MagerValp/fifogfx/schematics/Rev1/FIFO Board Rev1.pdf

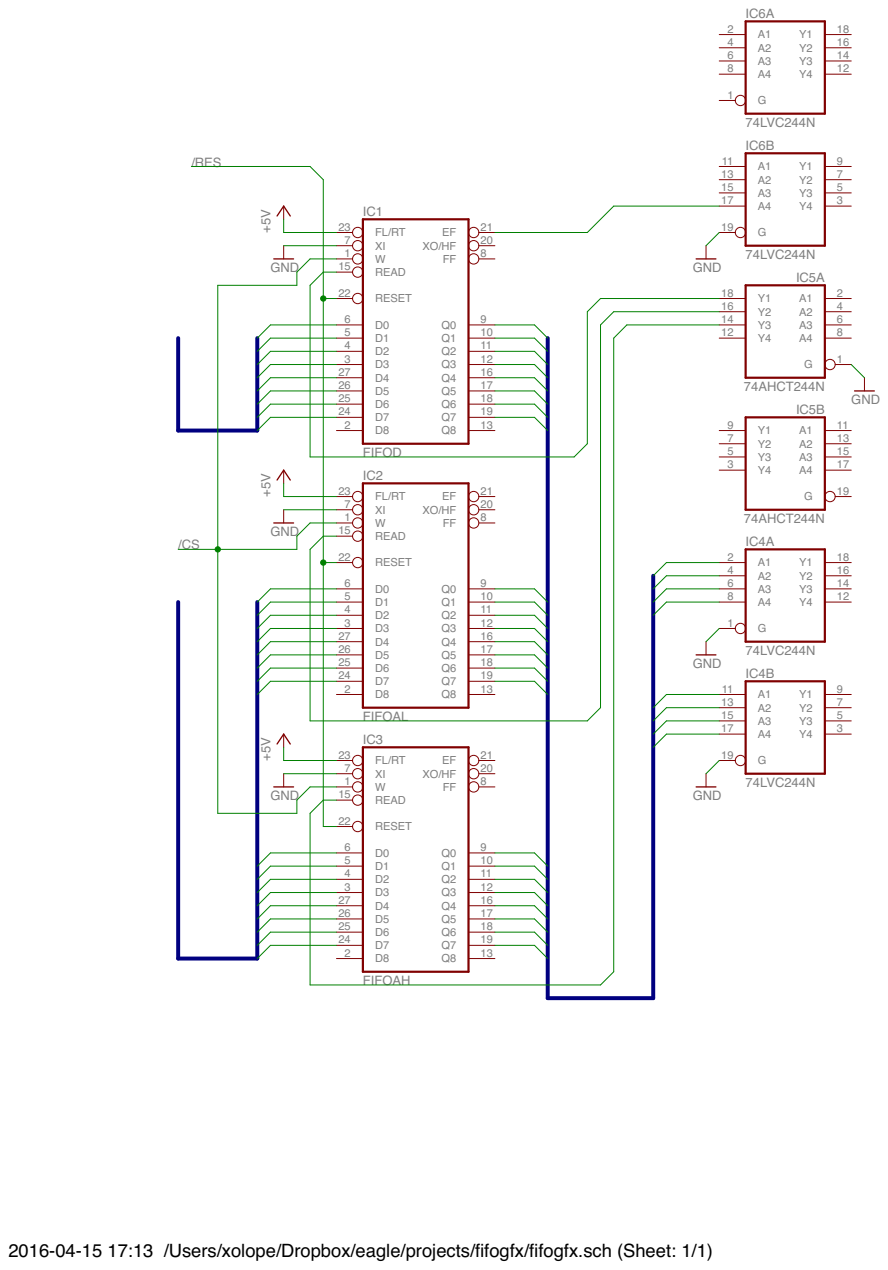
[picture p5: page 1]

2016-04-15 17:13 /Users/xolope/Dropbox/eagle/projects/fifogfx/fifogfx.sch (Sheet: 1/1)
