MagerValp/fifogfx/schematics/Rev2/FIFO Board Rev2.pdf

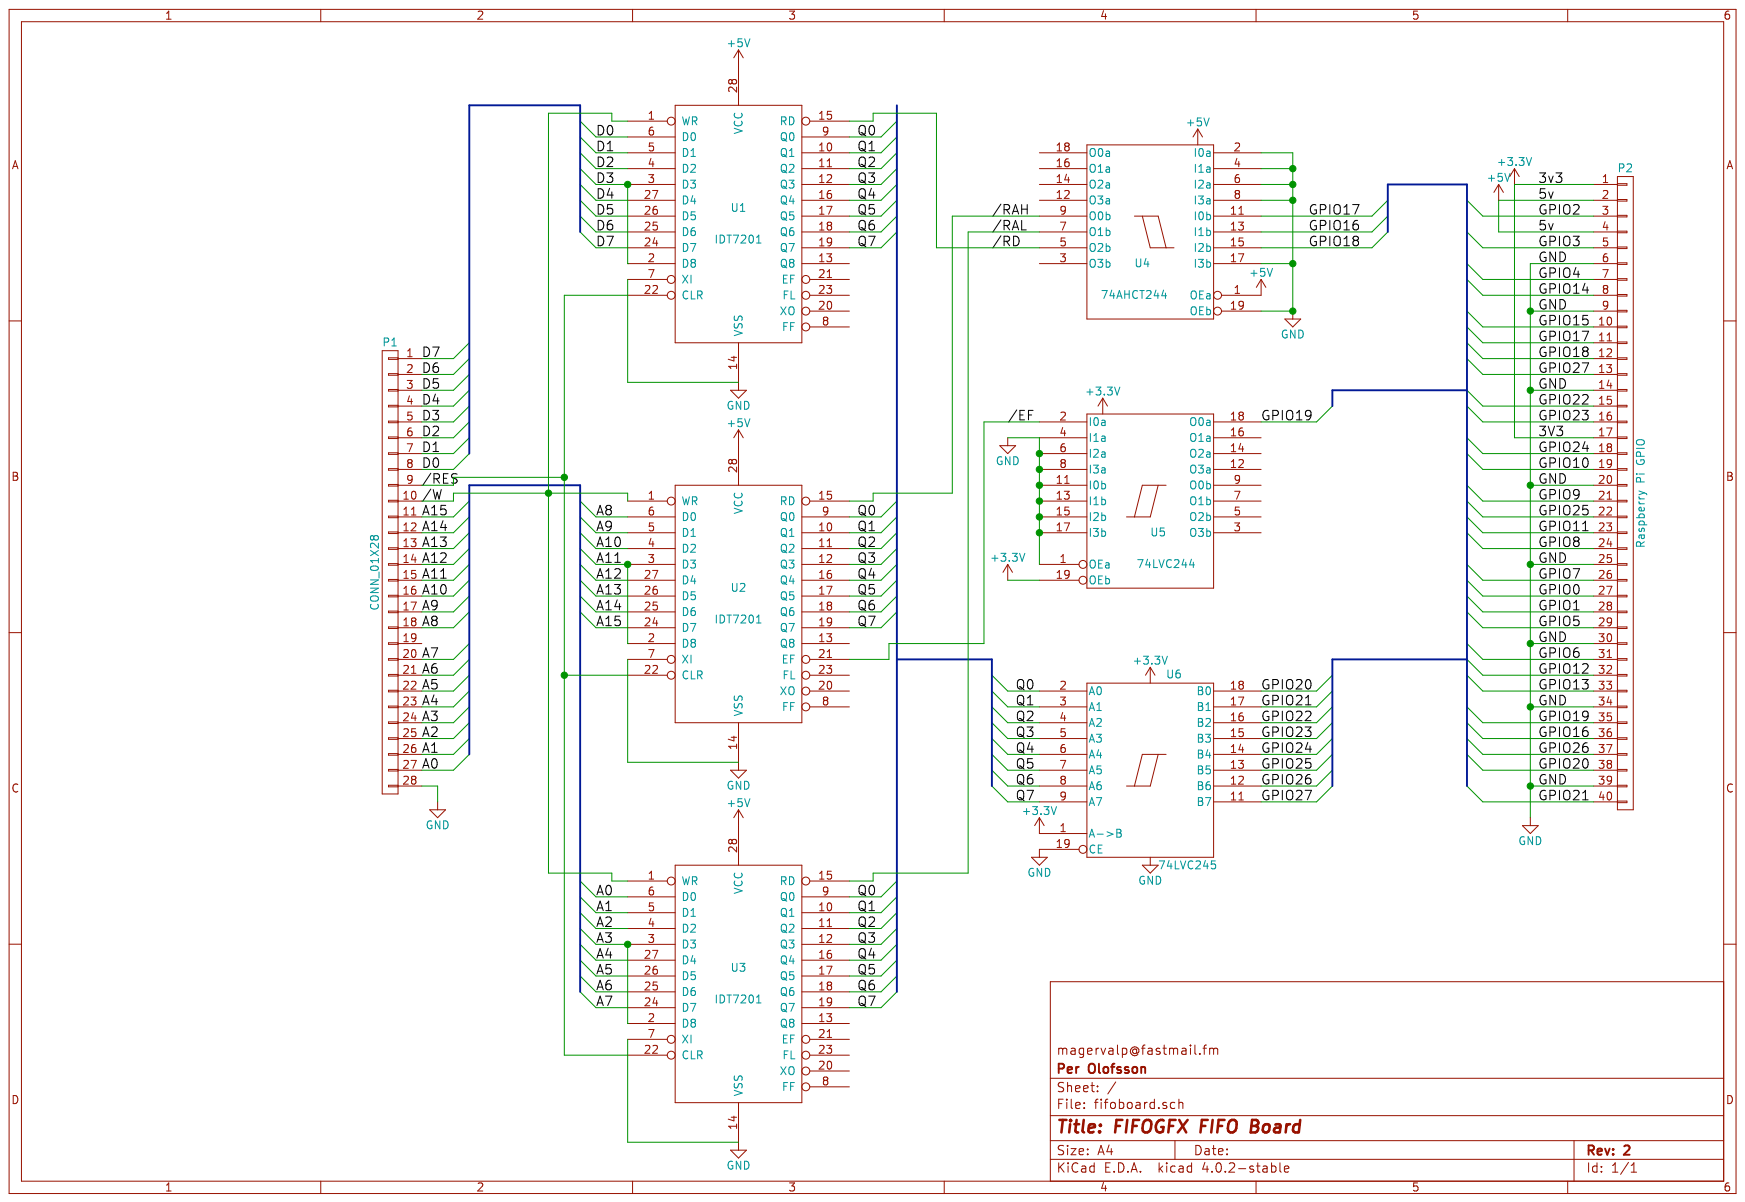
[picture p6: page 1]
