MagerValp/fifogfx/schematics/Rev3/c64cart.kicad_pcb

## KiCad design schematics/Rev3/c64cart.kicad_pcb (2016-06-28)

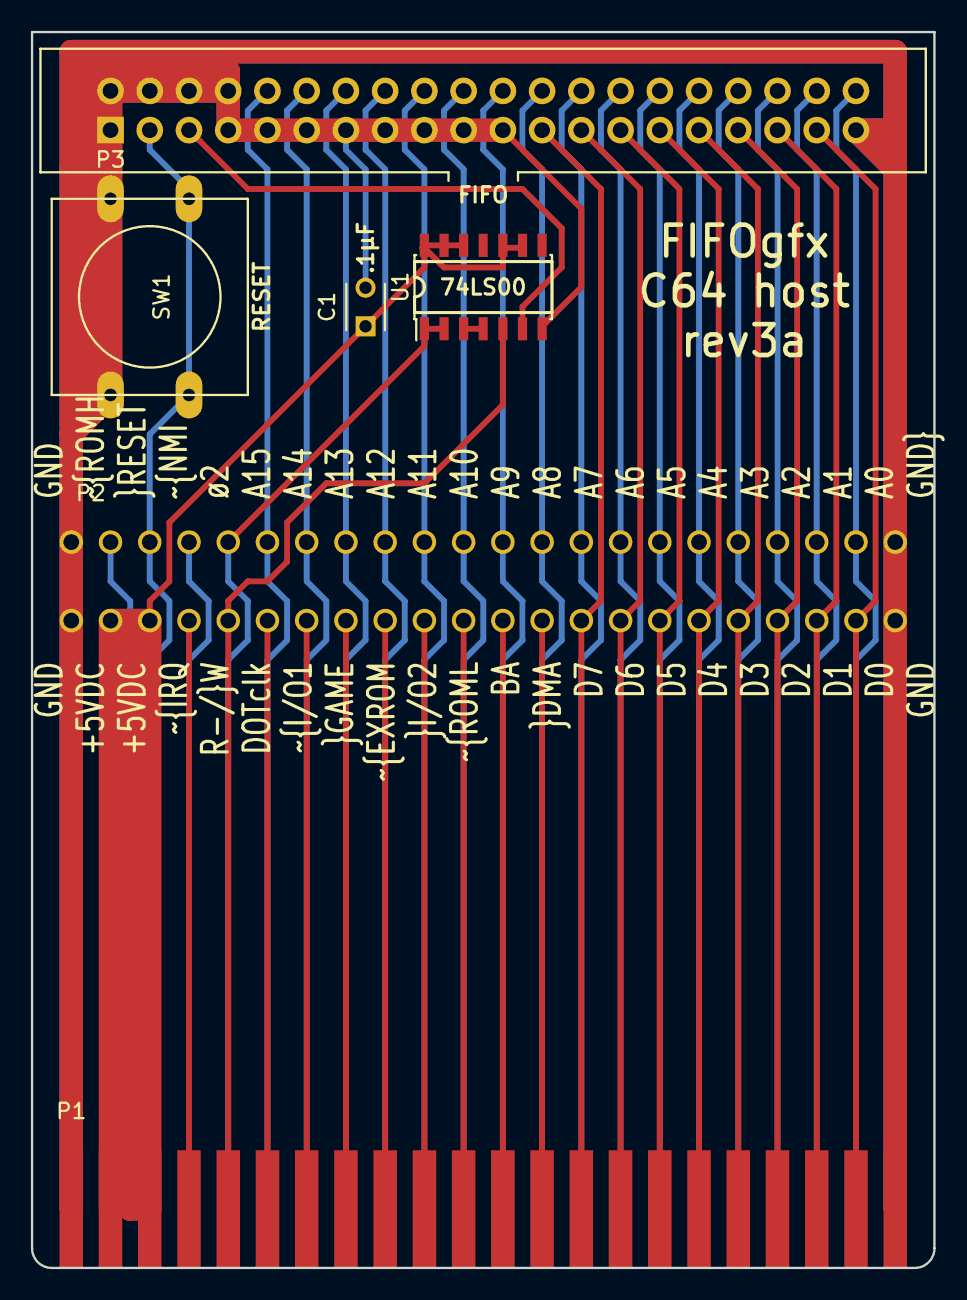
[picture p7: board c64cart.kicad_pcb from above]

Board: 2 copper layers, 58.4 x 80.0 mm, 6 parts (0 on the bottom side), 42 nets.

Parts:
C1: C; C_Disc_D3_P2.5
P1: c64cartedge
P2: c64cartedge; c64cartvert
P3: fifobus; FIFObus_header_40pin
SW1: SW_PUSH; SW_PUSH-12mm
U1: 74LS00; SOIC-14_3.9x8.7mm_Pitch1.27mm

Connections:
+5V: C1.1, P1.2, P1.3, P2.2, P2.3, U1.9, U1.10, U1.12, U1.13, U1.14
/A0: P1.43, P2.43, P3.40
/A1: P1.42, P2.42, P3.38
/A2: P1.41, P2.41, P3.36
/A3: P1.40, P2.40, P3.34
/A4: P1.39, P2.39, P3.32
/A5: P1.38, P2.38, P3.30
/A6: P1.37, P2.37, P3.28
/A7: P1.36, P2.36, P3.26
/A8: P1.35, P2.35, P3.24
/A9: P1.34, P2.34, P3.22
/A10: P1.33, P2.33, P3.20
/A11: P1.32, P2.32, P3.18
/A12: P1.31, P2.31, P3.16
/A13: P1.30, P2.30, P3.14
/A14: P1.29, P2.29, P3.12
/A15: P1.28, P2.28, P3.10
/BA: P1.12, P2.12
/D0: P1.21, P2.21, P3.37
/D1: P1.20, P2.20, P3.35
/D2: P1.19, P2.19, P3.33
/D3: P1.18, P2.18, P3.31
/D4: P1.17, P2.17, P3.29
/D5: P1.16, P2.16, P3.27
/D6: P1.15, P2.15, P3.25
/D7: P1.14, P2.14, P3.23
/DOTCLK: P1.6, P2.6
/PHI2: P1.27, P2.27, U1.1, U1.2
/R/~W: P1.5, P2.5, U1.5
/~DMA: P1.13, P2.13
/~EXROM: P1.9, P2.9
/~GAME: P1.8, P2.8
/~I/O1: P1.7, P2.7
/~I/O2: P1.10, P2.10
/~IRQ: P1.4, P2.4
/~NMI: P1.26, P2.26
/~RESET: P1.25, P2.25, P3.3, SW1.1
/~ROMH: P1.24, P2.24
/~ROML: P1.11, P2.11
GND: C1.2, P1.1, P1.22, P1.23, P1.44, P2.1, P2.22, P2.23, P2.44, P3.1, P3.2, P3.4, P3.6, P3.7, P3.8, P3.9, P3.11, P3.13, P3.15, P3.17, P3.19, P3.21, P3.39, SW1.2, U1.7
unnamed: P3.5, U1.6
unnamed: U1.3, U1.4
