MagerValp/fifogfx/images/Prototype-Rev1.jpg

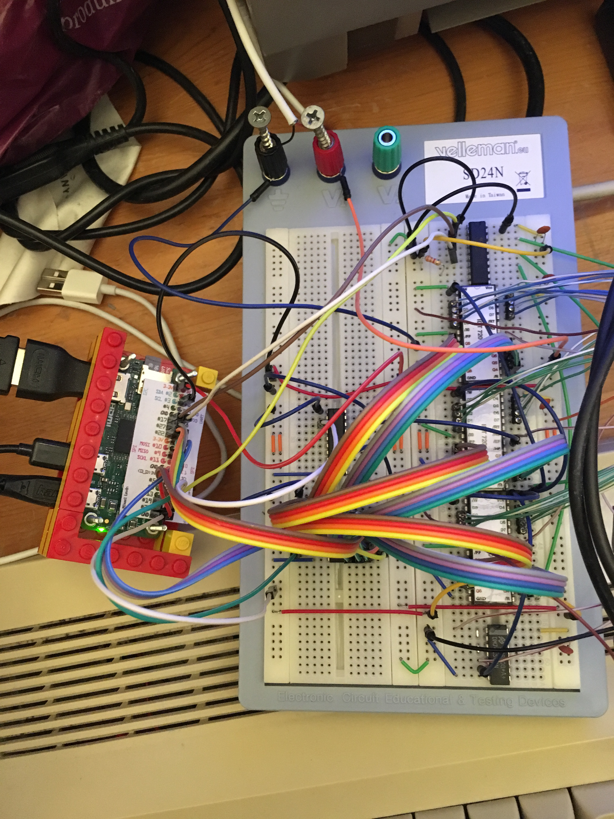
images/Prototype-Rev1.jpg
